PaulKlinger/freeform-virus-blinky/schematic.pdf

# GREEN GREEN GREEN GREEN GREEN

# D2 D1 D3 D5 D4 D6 D7 D8

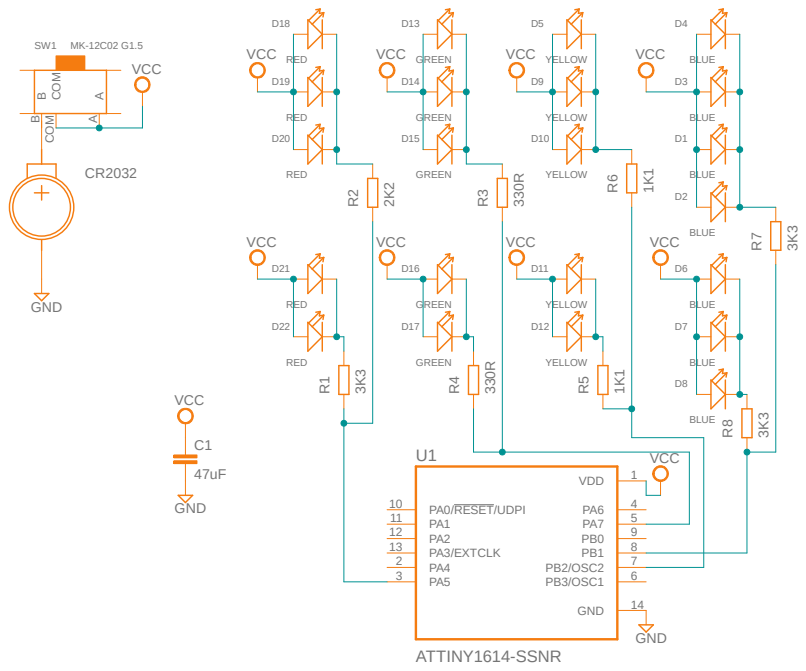
[picture p2: page 1]
