PaulKlinger/freeform-virus-blinky/schematic.sch

## EAGLE design schematic.sch (2020-03-22)

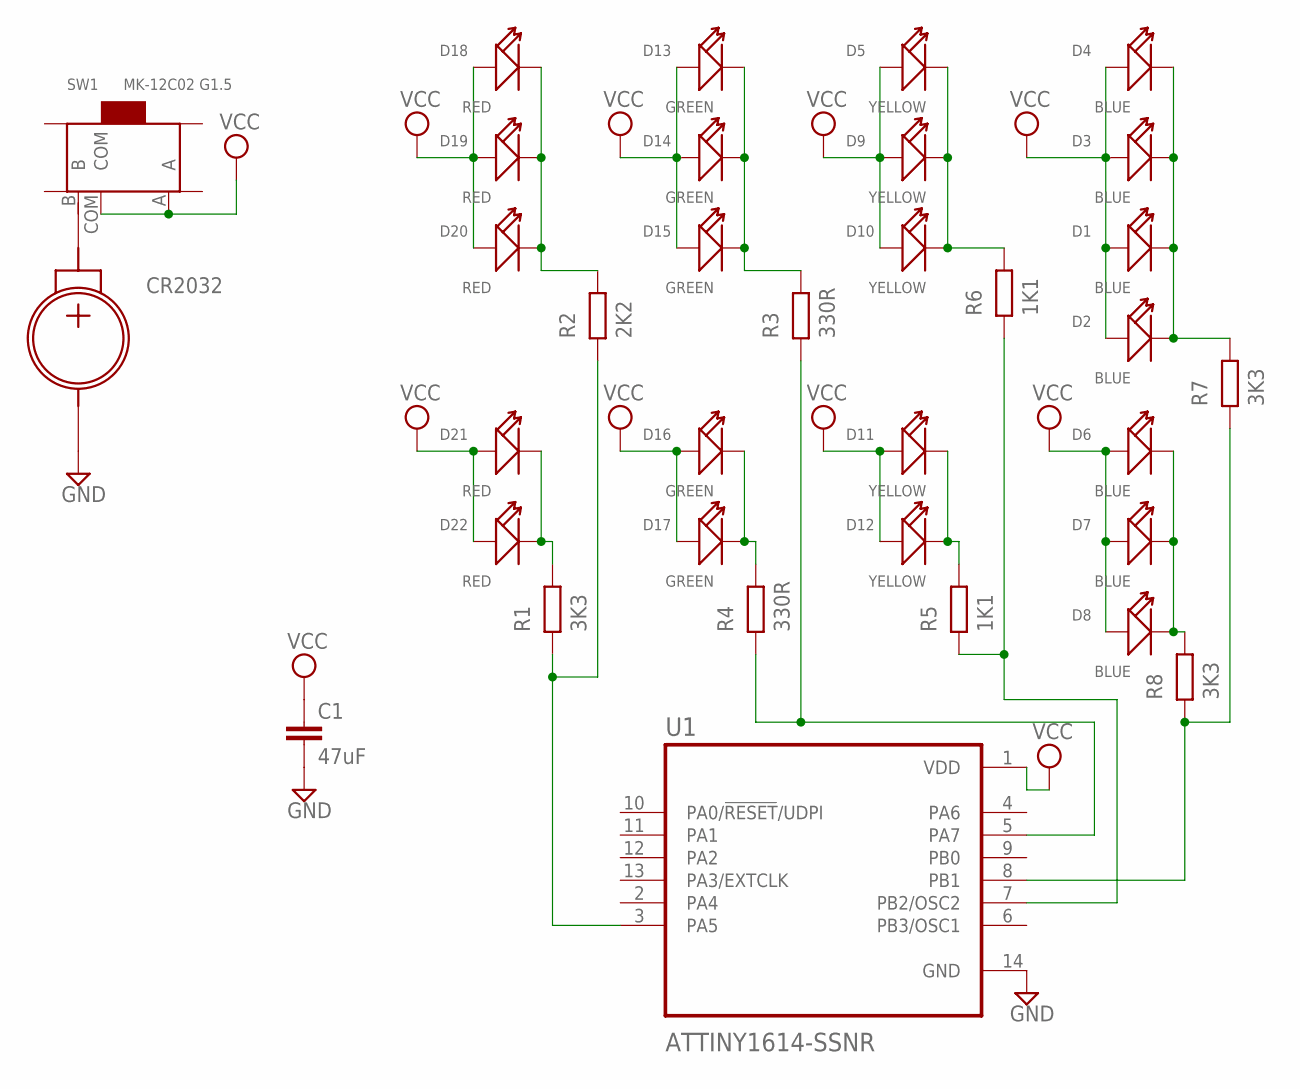
[picture p3: schematic schematic.sch]

Parts:
C1: 47uF; C1206
CR2032: BS-7CR2032_COIN_CELL_BATTERY_HOLDER; BS-7
D1, D2, D3, D4, D6, D7, D8: BLUE; LED2-2.54-D3.0MM
D5, D9, D10, D11, D12: YELLOW; LED2-2.54-D3.0MM
D13, D14, D15, D16, D17: GREEN; LED2-2.54-D3.0MM
D18, D19, D20, D21, D22: RED; LED2-2.54-D3.0MM
R1, R7, R8: 3K3; RESAD724W46L381D178B
R2: 2K2; RESAD724W46L381D178B
R3, R4: 330R; RESAD724W46L381D178B
R5, R6: 1K1; RESAD724W46L381D178B
SW1: MK-12C02 G1.5; SW7-SMD-L6.7X2.7X3.2MM
U1: ATTINY1614-SSNR; SOIC127P600X175-14N

Connections:
GND: C1.2, CR2032.NEG, U1.14 (GND)
unnamed: D13.K (-), D14.K (-), D15.K (-), R3.2
unnamed: D21.K (-), D22.K (-), R1.2
unnamed: R1.1, R2.1, U1.3 (PA5)
unnamed: D18.K (-), D19.K (-), D20.K (-), R2.2
unnamed: R3.1, R4.1, U1.5 (PA7)
unnamed: D16.K (-), D17.K (-), R4.2
unnamed: D5.K (-), D9.K (-), D10.K (-), R6.2
unnamed: D11.K (-), D12.K (-), R5.2
unnamed: R5.1, R6.1, U1.7 (PB2/OSC2)
unnamed: D6.K (-), D7.K (-), D8.K (-), R8.2
unnamed: D1.K (-), D2.K (-), D3.K (-), D4.K (-), R7.2
unnamed: R7.1, R8.1, U1.8 (PB1)
VCC: C1.1, D1.A (+), D2.A (+), D3.A (+), D4.A (+), D5.A (+), D6.A (+), D7.A (+), D8.A (+), D9.A (+), D10.A (+), D11.A (+), D12.A (+), D13.A (+), D14.A (+), D15.A (+), D16.A (+), D17.A (+), D18.A (+), D19.A (+), D20.A (+), D21.A (+), D22.A (+), SW1.A, SW1.COM, U1.1 (VDD)
