PaulKlinger/freeform-virus-blinky/embedded_code/sars_cov_2_sequence.c

#include "sequence.h"


/* Generated from .fasta using encode_genome.py */
/* 2 bits per base, 00:A, 01:C, 10:G, 11:T */
const uint8_t sequence_data[] = {
60, 10, 252, 197, 245, 74, 193, 1, 65, 65, 253, 141, 223, 178, 55, 189,
220, 6, 7, 240, 13, 238, 233, 237, 29, 167, 147, 159, 46, 71, 70, 75,      
48, 240, 193, 195, 199, 182, 248, 74, 17, 139, 7, 109, 205, 247, 146, 158, 
124, 107, 246, 214, 239, 146, 88, 211, 73, 19, 114, 191, 109, 106, 238, 22,
2, 176, 142, 136, 151, 237, 94, 191, 65, 136, 1, 17, 181, 7, 75, 249,      
123, 252, 74, 246, 97, 185, 219, 27, 167, 250, 33, 214, 232, 162, 183, 205,
34, 145, 180, 19, 124, 8, 233, 31, 186, 124, 178, 11, 224, 2, 155, 254,    
93, 7, 224, 73, 92, 238, 244, 208, 27, 218, 57, 216, 30, 69, 211, 173,     
59, 206, 190, 39, 172, 146, 7, 96, 164, 244, 177, 173, 178, 235, 136, 71,  
235, 181, 251, 87, 78, 234, 96, 49, 75, 167, 197, 144, 175, 125, 246, 194,
6, 176, 192, 162, 122, 233, 76, 188, 105, 150, 55, 2, 211, 248, 124, 166,
24, 159, 164, 120, 215, 206, 8, 255, 66, 0, 122, 4, 112, 19, 36, 186,
239, 21, 184, 29, 57, 184, 159, 6, 138, 164, 196, 118, 115, 182, 48, 65,
247, 186, 87, 142, 156, 87, 126, 46, 79, 2, 23, 220, 145, 185, 235, 2,
125, 57, 31, 237, 96, 65, 232, 127, 62, 17, 194, 42, 187, 49, 231, 150,
224, 78, 36, 224, 62, 126, 177, 26, 6, 247, 128, 34, 115, 131, 228, 132,
95, 248, 15, 3, 233, 2, 3, 248, 69, 244, 58, 160, 237, 64, 255, 179,
245, 124, 15, 83, 13, 8, 115, 208, 80, 171, 224, 8, 0, 159, 142, 159,
206, 172, 131, 216, 222, 220, 212, 190, 109, 20, 14, 14, 65, 64, 238, 95,
208, 119, 78, 11, 184, 211, 238, 184, 7, 211, 164, 134, 166, 63, 239, 2,
81, 249, 131, 254, 233, 30, 32, 254, 28, 8, 43, 148, 113, 251, 175, 31,
21, 64, 57, 239, 188, 3, 243, 237, 73, 59, 68, 61, 32, 178, 133, 226,
76, 183, 229, 131, 20, 195, 131, 122, 126, 0, 83, 223, 108, 42, 235, 100,
115, 229, 254, 138, 123, 187, 221, 243, 190, 190, 83, 4, 46, 229, 207, 171,
212, 110, 114, 103, 4, 202, 251, 5, 49, 43, 190, 250, 32, 175, 88, 43,
124, 56, 65, 125, 248, 12, 117, 0, 34, 2, 208, 77, 12, 251, 235, 135,
240, 31, 14, 8, 141, 148, 243, 254, 147, 127, 247, 159, 81, 11, 159, 251,
160, 30, 224, 43, 250, 60, 192, 147, 208, 16, 62, 248, 53, 238, 176, 255,
2, 241, 0, 160, 9, 192, 2, 185, 122, 12, 250, 224, 72, 13, 12, 120,
181, 223, 206, 79, 228, 210, 41, 231, 110, 251, 24, 208, 255, 117, 100, 119,
224, 30, 116, 3, 222, 230, 239, 241, 32, 165, 156, 193, 12, 114, 58, 15,
209, 44, 244, 120, 135, 79, 142, 115, 142, 244, 77, 227, 250, 113, 193, 13,
203, 236, 58, 92, 79, 18, 186, 239, 189, 47, 135, 217, 46, 156, 28, 19,
127, 164, 123, 243, 128, 7, 64, 86, 215, 227, 233, 248, 34, 11, 240, 160,
174, 200, 191, 124, 136, 107, 234, 3, 239, 3, 243, 116, 23, 185, 251, 128,
251, 107, 161, 3, 237, 23, 185, 2, 128, 240, 162, 46, 244, 132, 247, 240,
159, 176, 48, 63, 250, 127, 187, 158, 29, 205, 60, 250, 232, 156, 7, 192,
151, 224, 252, 174, 1, 63, 180, 100, 116, 10, 143, 177, 32, 46, 239, 3,
82, 32, 128, 122, 92, 116, 229, 220, 2, 85, 0, 128, 243, 125, 242, 42,
32, 17, 245, 68, 130, 239, 4, 138, 11, 237, 248, 1, 235, 143, 196, 20,
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
};

const struct sequence sars_cov_2_sequence = {
    .data = (uint8_t*) sequence_data,
    .n_bases = 29903
};
