PaulKlinger/freeform-virus-blinky/embedded_code/sars_cov_2_sequence.h

#ifndef SARS_COV_2_SEQUENCE_H
#define	SARS_COV_2_SEQUENCE_H

#ifdef	__cplusplus
extern "C" {
#endif
    #include "sequence.h"

    const struct sequence sars_cov_2_sequence;


#ifdef	__cplusplus
}
#endif

#endif	/* SARS_COV_2_SEQUENCE_H */
