PaulKlinger/freeform-virus-blinky/(commit log)

2020-03-22 added schematic
    [schematic.sch]
2020-03-22 link to schematic
2020-03-22 added assembly tips
2020-04-16 added resistors to component list
2021-08-16 bugfix (sequence was cut off at end)
    [sars_cov_2_sequence.c]
